openhp/HeatPumpController/m_HeatPump_scheme2.png

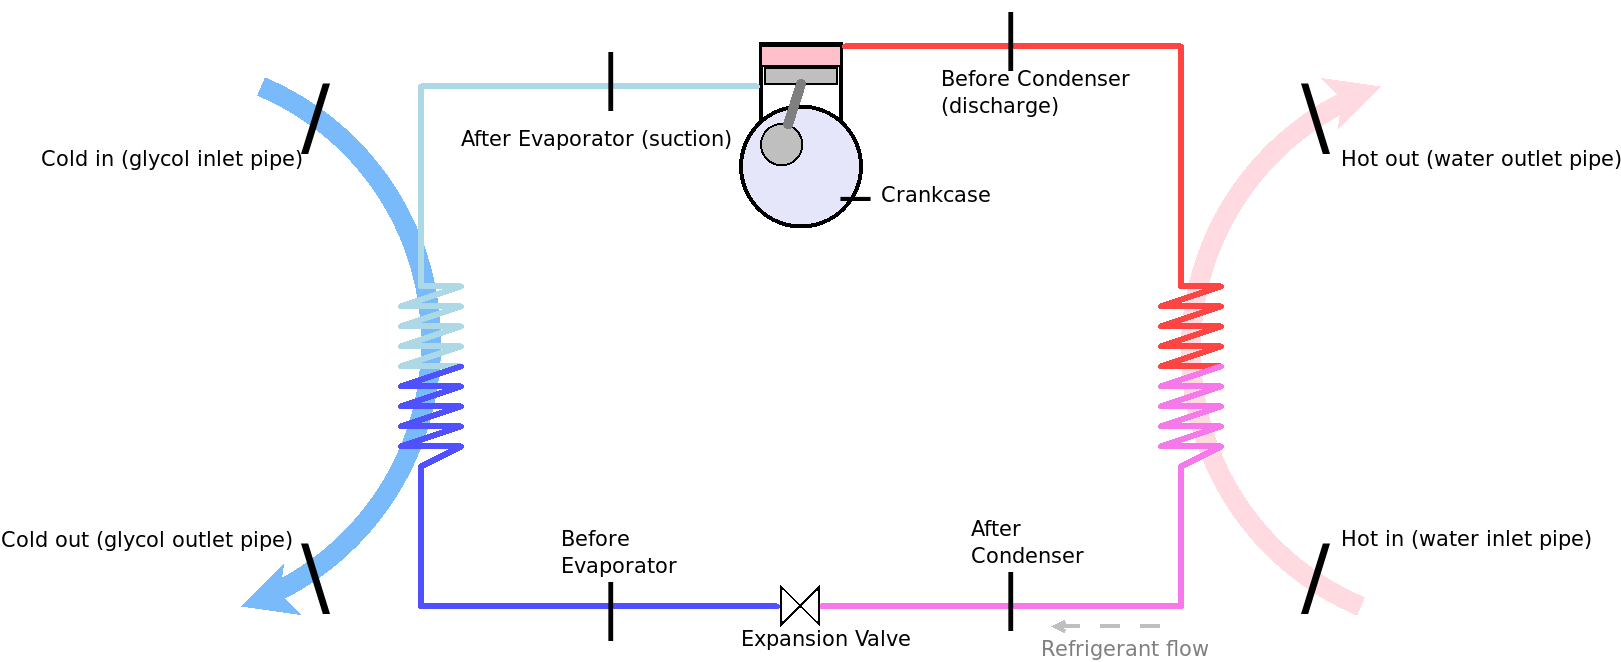
m_HeatPump_scheme2.png
