openhp/HeatPumpController/docs/m_c_assembly_40pins.jpg

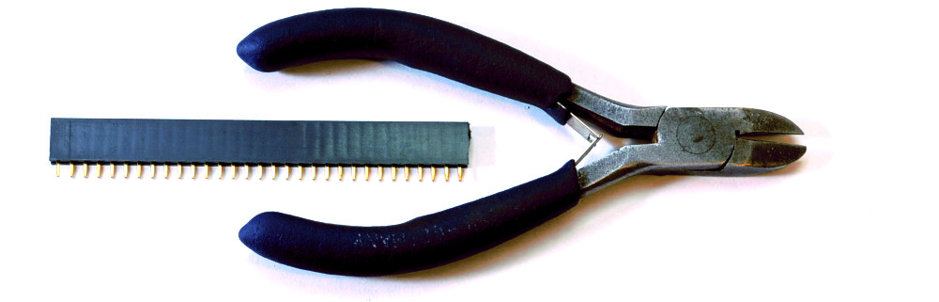
docs/m_c_assembly_40pins.jpg
