openhp/HeatPumpController/docs/m_c_assembly_add1.jpg

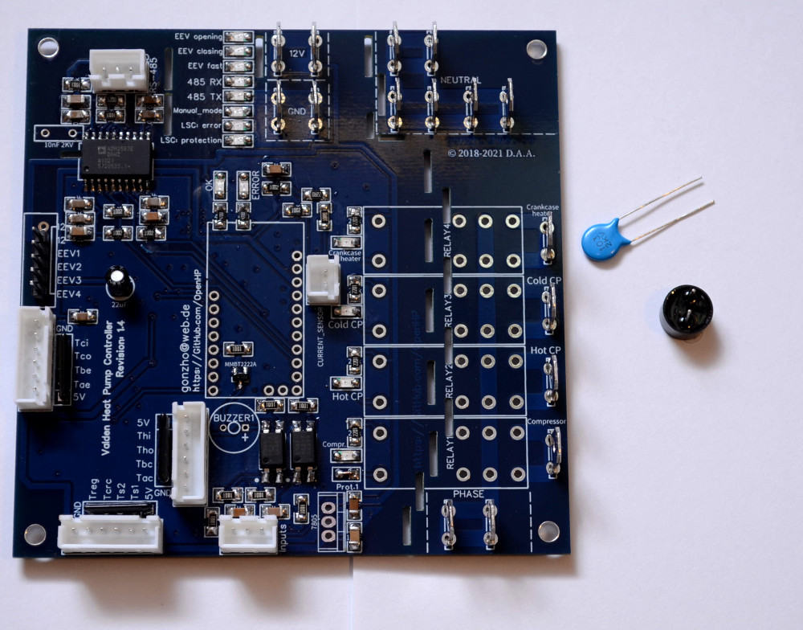
docs/m_c_assembly_add1.jpg
