openhp/HeatPumpController/docs/m_c_assembly_add_solder.jpg

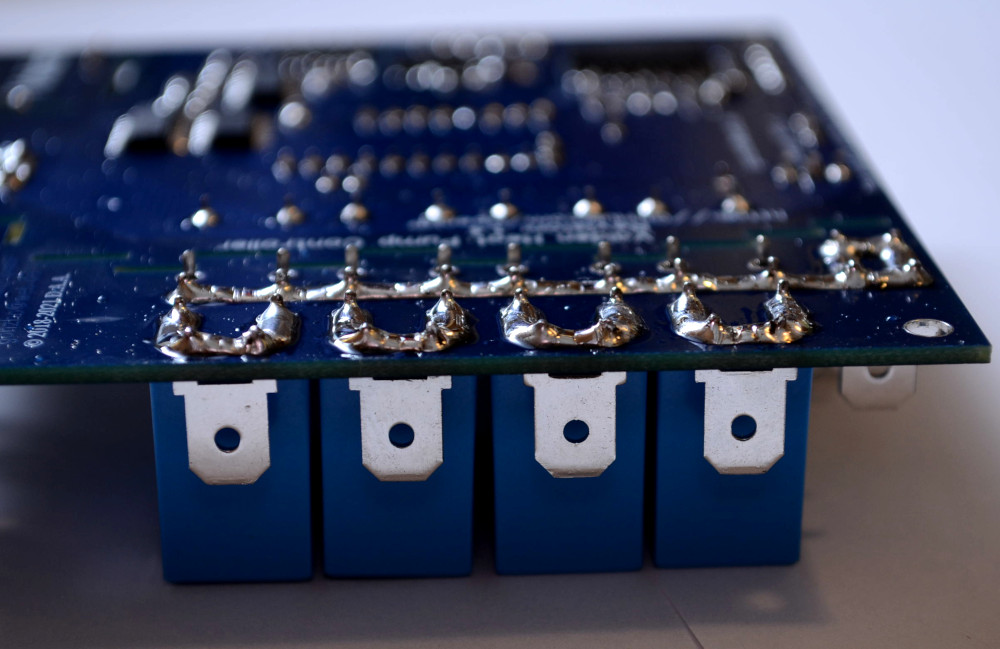
docs/m_c_assembly_add_solder.jpg
