openhp/HeatPumpController/docs/m_c_assembly_arduino_1.jpg

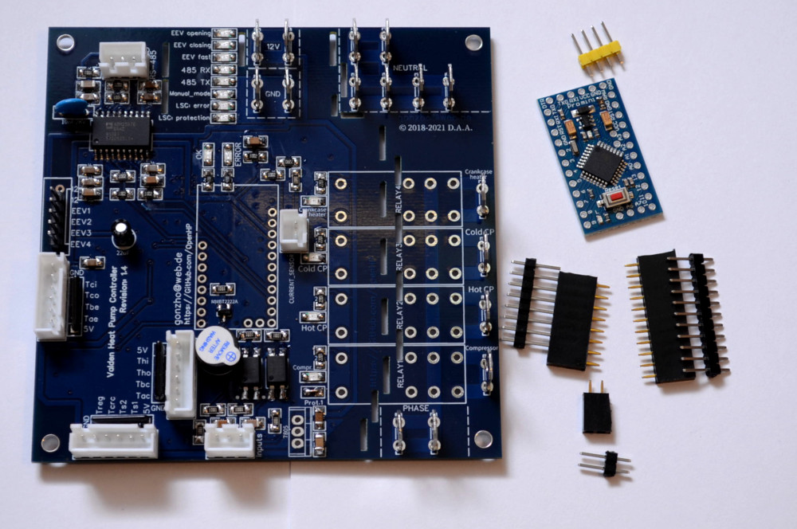
docs/m_c_assembly_arduino_1.jpg
