openhp/HeatPumpController/docs/m_c_assembly_arduino_2.jpg

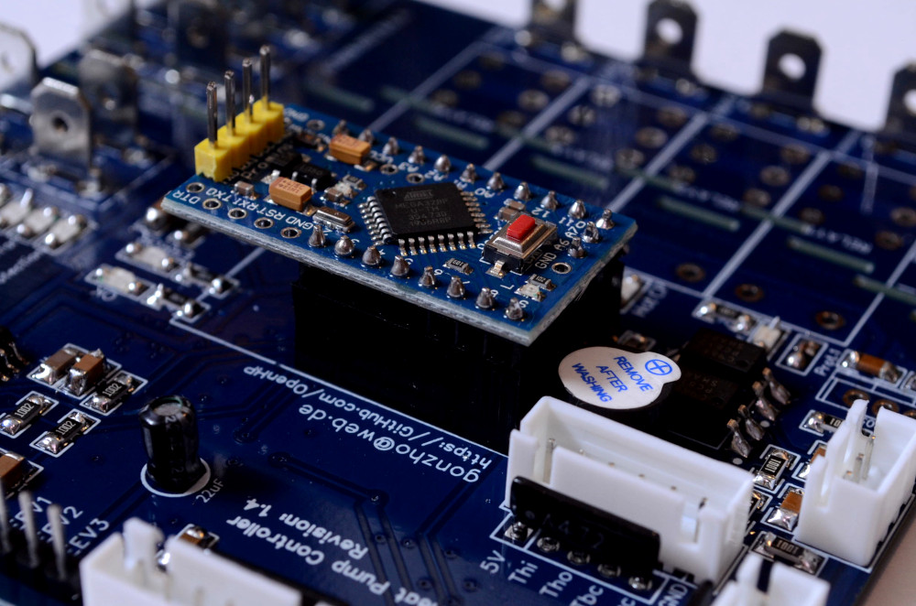
docs/m_c_assembly_arduino_2.jpg
