openhp/HeatPumpController/docs/m_c_assembly_blade_connectors.jpg

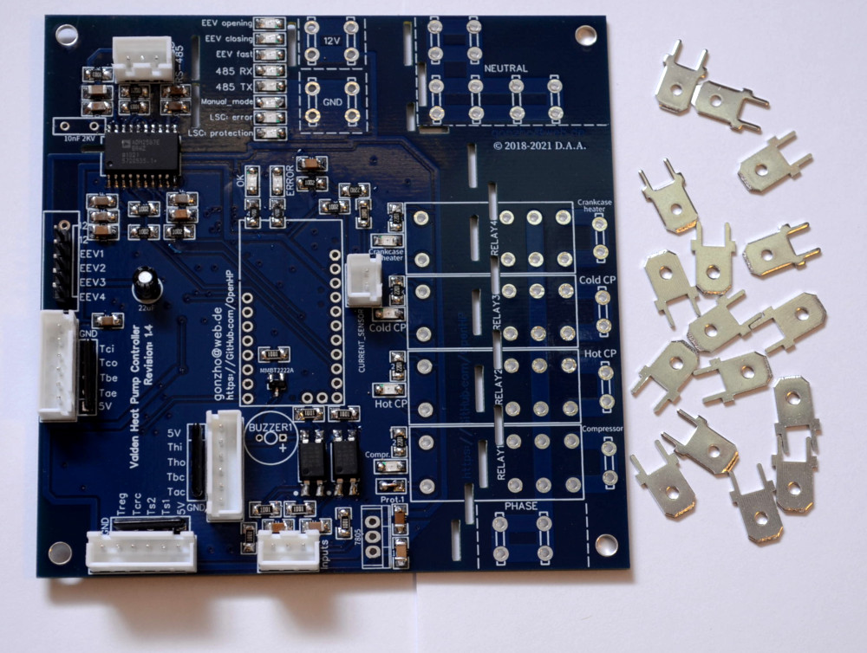
docs/m_c_assembly_blade_connectors.jpg
