openhp/HeatPumpController/docs/m_c_assembly_capacitors.jpg

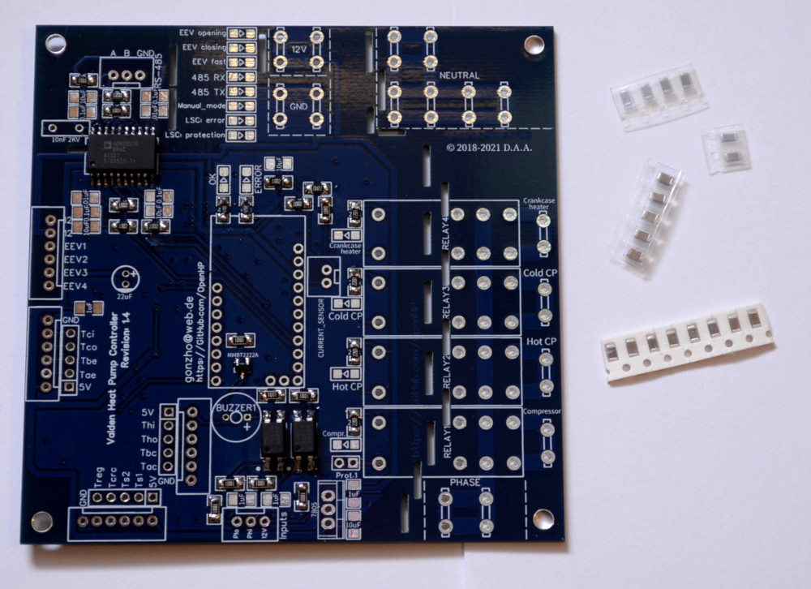
docs/m_c_assembly_capacitors.jpg
