openhp/HeatPumpController/docs/m_c_assembly_completed_back.jpg

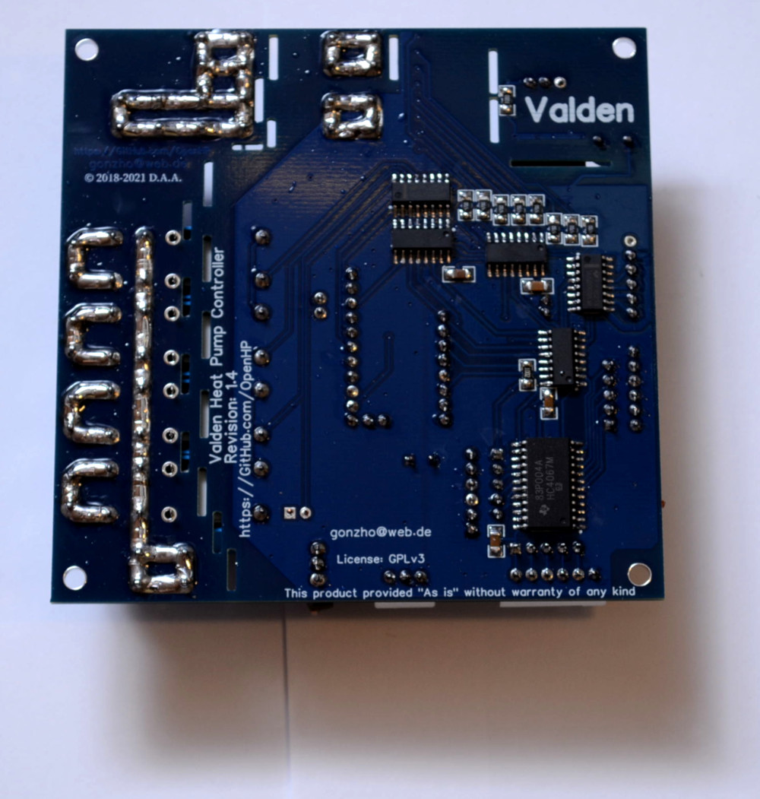
docs/m_c_assembly_completed_back.jpg
