openhp/HeatPumpController/docs/m_c_assembly_connectors.jpg

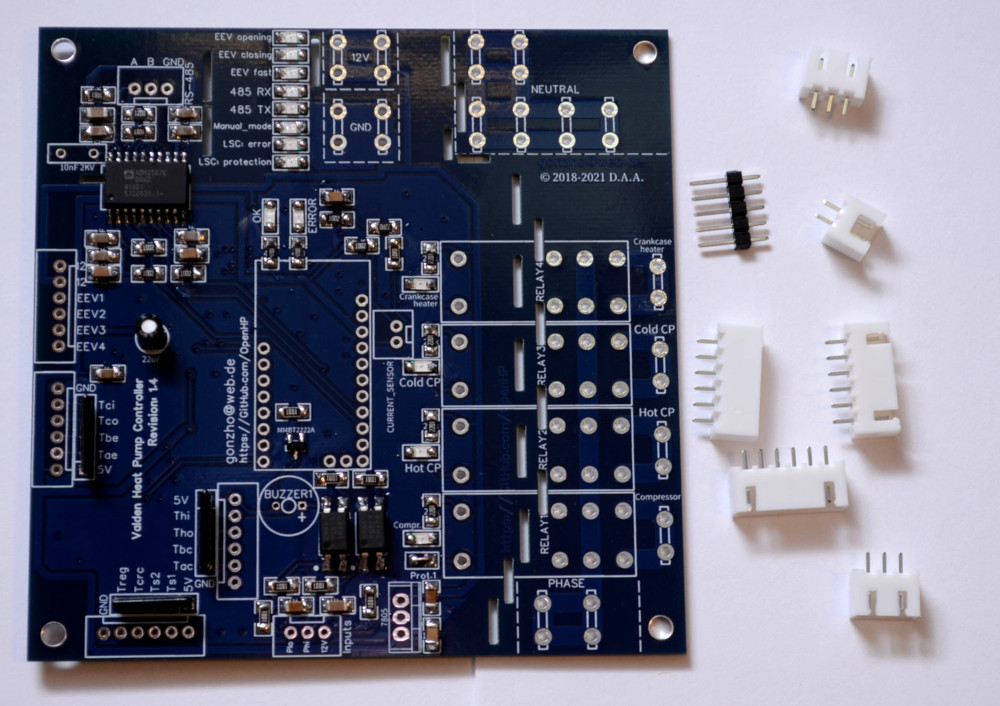
docs/m_c_assembly_connectors.jpg
