openhp/HeatPumpController/docs/m_c_assembly_ICs.jpg

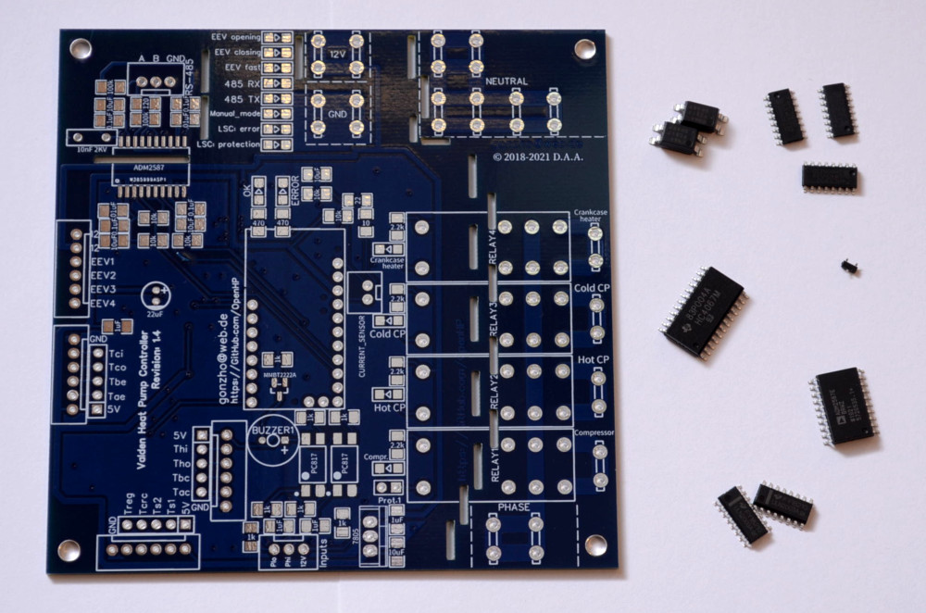
docs/m_c_assembly_ICs.jpg
