openhp/HeatPumpController/docs/m_c_assembly_LEDs.jpg

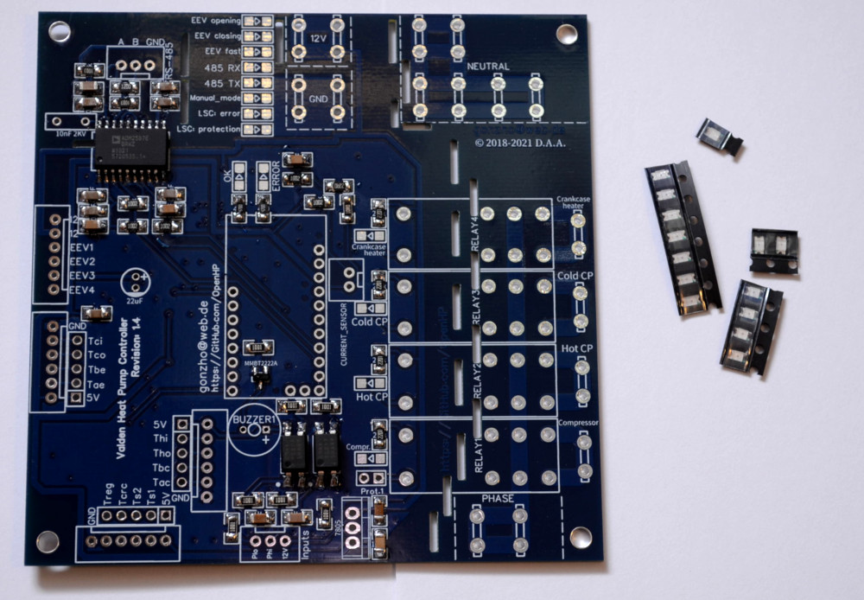
docs/m_c_assembly_LEDs.jpg
