openhp/HeatPumpController/docs/m_c_assembly_PCB.jpg

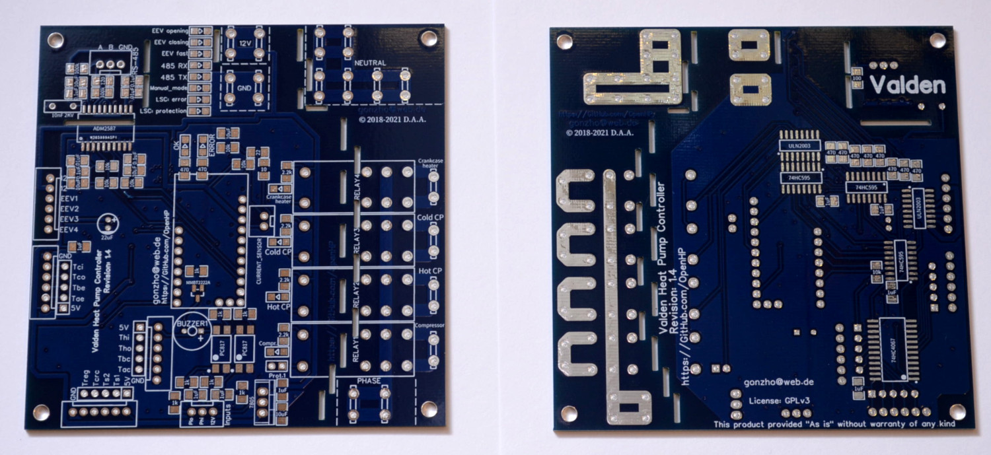
docs/m_c_assembly_PCB.jpg
