openhp/HeatPumpController/docs/m_c_assembly_r_nets.jpg

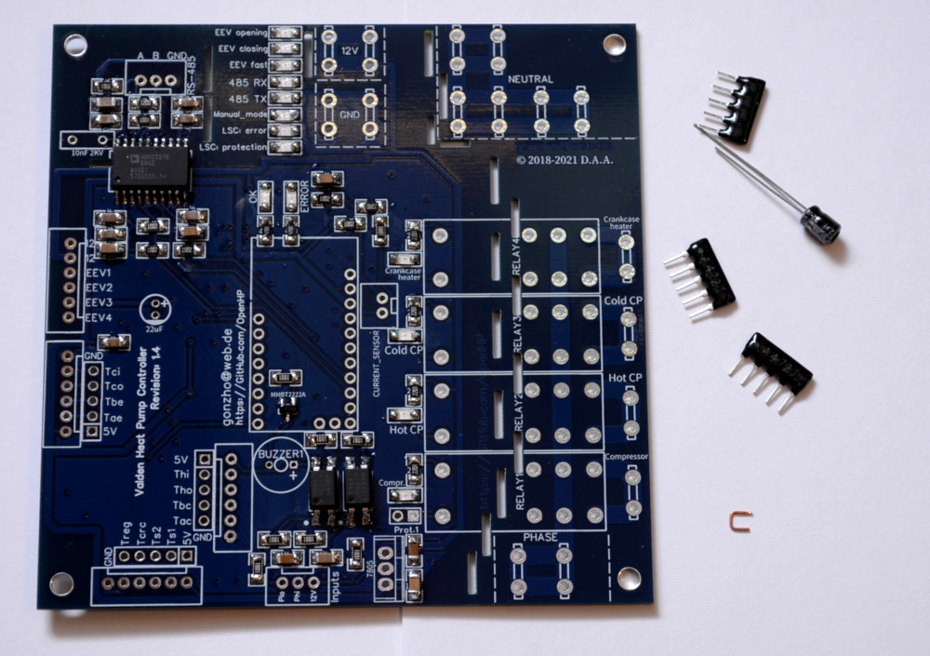
docs/m_c_assembly_r_nets.jpg
