openhp/HeatPumpController/docs/m_c_assembly_relays.jpg

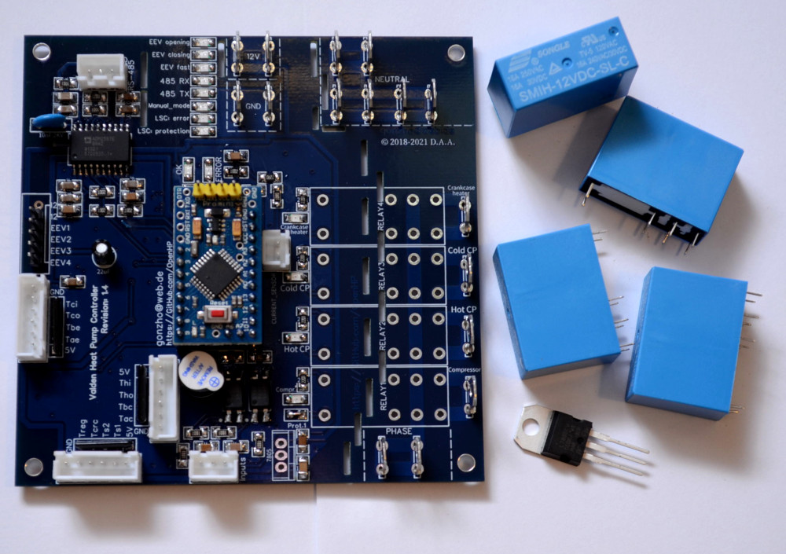
docs/m_c_assembly_relays.jpg
