openhp/HeatPumpController/docs/m_c_assembly_resistors.jpg

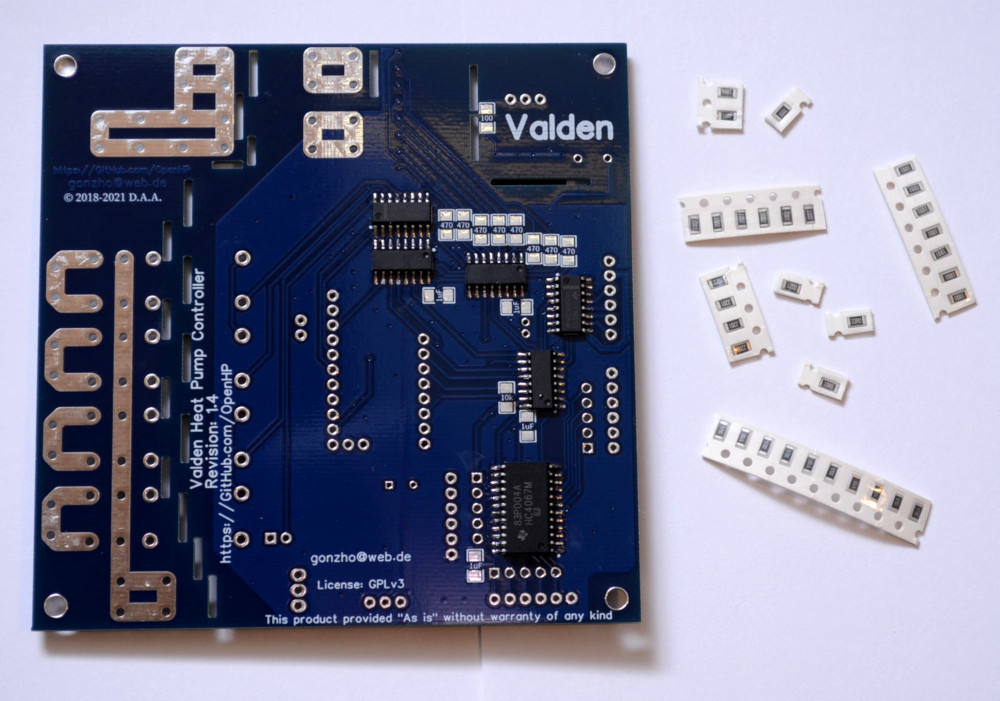
docs/m_c_assembly_resistors.jpg
