openhp/HeatPumpController/(threads)

Thread 1 (2021-12-07):

Some question ...

kris86k, 2021-12-07:
Hi.
Can u tell as electronic parts cost? I mean similar. It's about 30, 50, 100EUR?
Do you plaining to add wi-fi?
Are you planning to develop the project?
Controller works fine? Any issues?
Its prepare to drive 4 way valve to heat hot water and heat home?

BR,
Kris.

Tomppa707, 2021-12-08:
Hi
Interested to use my own heatpump.
How well this EEV control works..  how well it follow and stays in desired superheat setting?
And is there possible add relay for 4 way valve to defrost use.. Air source heatpump use?
Seems very good software and board also!
BR,
Tomppa

Thread 2 (2022-03-13):

Design files availability?

kaklik, 2022-03-13:
Hello,

are there original PCB design files somewhere? E.g. KiCAD schematics or complete project file?  I need to change position and type of connectors used.  Also I want to change electromagnetic relays by solid-state switches.

Thanks

samuk, 2022-04-04:
I would also like these if possible.

samuk, 2022-09-01:
Any news?

ZoltanPerhacs, 2023-01-10:
It seems that it uses the same hardware as the Cheap Heat Pump Controller.
You can find the schematic there.
https://github.com/gonzho000/chpc

kaklik, 2023-01-10:
> It seems that it uses the same hardware as the Cheap Heat Pump Controller. You can find the schematic there. https://github.com/gonzho000/chpc

Hi, it seems to be an important point. But unfortunately, the [chpc](https://github.com/gonzho000/chpc) repository is a simple folder full of bitmap images. Therefore it does not provide a step into the future of the open-source design of heat pump.

ZoltanPerhacs, 2023-01-10:
> > It seems that it uses the same hardware as the Cheap Heat Pump Controller. You can find the schematic there. https://github.com/gonzho000/chpc
>
> Hi, it seems to be an important point. But unfortunately, the [chpc](https://github.com/gonzho000/chpc) repository is a simple folder full of bitmap images. Therefore it does not provide a step into the future of the open-source design of heat pumps.

Yes, full of bitmaps... like this repo... :)
But there is a pdf with the schematic.
Not a huge task to put it into KiCAD... and design a custom PCB or replicate this PCB made by Valden.

samuk, 2023-01-10:
Admitting this repo is useless and starting again is probably required.

I think Jpearce the author of this page https://www.appropedia.org/Pumps_for_Peace has a PhD student starting work soon, so they may be able to help organise, although I don't expect they will be able to do the PCB design.

kaklik, 2023-01-11:
Ok, that seems like starting the project from a scratch is necessary.  But it reveals the usual questions:

- Is the current architecture still worthwhile to use or is better to redesign it?
- Are there some points of compatibility that should be preserved?

I am generally able to make PCB design work, but I am unable to code and maintain the required firmware. Related to the HW I have some idea of how it should be designed to be durable and has long service use without maintenance. For example is needed to avoid screwed terminals, electromechanical contact relays, etc. Of course, this requirement increases the price, which probably not everyone will accept.
Generally, we use a workflow where the prototype is made from [MLAB modules](https://www.mlab.cz/modules?status=2). Then is extensively tested in several units.  After that, the application PCB is designed, from each module design made by  KiCAD.

samuk, 2023-01-11:
Whether to redesign or not is a good question.

I'd be inclined to go with software compatibility at least for a first iteration. The OpenheatPump code seems to have more features than the older cheap heatpump https://www.diffchecker.com/8kxiqY6X/

I agree that longevity is desirable. I wonder if it's worth using  "screwed terminals, electromechanical contact relays" in initial prototypes and then developing more robust solutions once we have a working prototype?

I'd not heard of MLAB before, I'll check it out!

Thread 4 (2024-12-08):

4 way valve functionality request

CarloContu98, 2024-12-08:
Hello, I'm creating an issue ticket since I didn't find any way to contact you directly, but it's really more a request than an issue.

I've recently bought an old house with my gf and I'm trying to renovate everything by myself.
For the domestic hot water I'm using a refurbished 500 liters boiler where I submerged a copper-pipe-spiral that acts as a condenser.
But for the evaporator side I can't implement the ground loops yet, so I'm using an air unit.
Therefore I need to implement the 4 way valve, to de-ice the external unit.

I've already ordered and built your board, which I really like in quality instead of the stuff from Aliexpress and similar products, but I'm struggling to edit the code myself to add the 4 way valve functionality.
I would love if you could help me implement it, even under payment or donation to the project of course.
I thought about using the "hot side recirculation" relay to command the 4 way valve since my hot side is passive and don't need recirculation.

In await for your response, best regards,
Carlo Alberto

burner-, 2025-03-26:
De icing is much more than just 4 way valve. Proper deicing measure outdoor ambient temp. Under set point it star compare evaporator and ambient temp. If evaporator - ambient temp delta goes too high it star de icing cycle. At that sycle compressor needs to stop and after some while fan need stop. Then 4 way valve turn, compressor start after oil settle time as evv closed position. When max pressure is achaived evv will open. That cause huge temperature rush to evaporator. Unit measure de icing time and temperature when minimum time and requested return gas temperature is achived (probably something like +15c is proper) it start outdoor fan with full power and stop compressor. That will blow droplets away. After that fan stops, evv open and back pressure got released. After that 4 way valve return back to heating position, compressor idle timer wait that oil settle and after that normal compressor start sequency start.

Sniffer-Daniel, 2025-09-20:
I am also interested in an update specifically for de-icing. It would be very nice if such an update to the code was made. I am currently rebuilding a 9kw(copeland zh30k4e) air/water heat pump for this particular system (Valden heat pump controller).

My name is Daniel and I am from Sweden. :)

Thread 5 (2025-05-02):

Where to get built?

nzfarmer1, 2025-05-02:
I recently tried to get  https://www.pcbway.com/ to build this for me, bit there unavailable components and I had to take the risk that I could find and solder these on myself.

As I'm an embedded guy with a broken hotwater heatpump, I simply want a board to start from and am happy to pay to have  it completed.

Any suggestions on where I might go for a finished board?

Thanks
